szuwei-yeh/flashattn-accelerator/docs/v2/qwen/accuracy.csv

job | q_head | comparison | relative_l2 | rmse | max_abs
N16 | 0 | quantized_vs_original | 0.04211902249304501 | 0.0132997888426463 | 0.10851025581359863
N16 | 0 | fixed_vs_quantized | 0.008673786723758865 | 0.002759703978349715 | 0.015506148338317871
N16 | 0 | fixed_vs_original | 0.04117019603529227 | 0.013000180950784344 | 0.10507124662399292
N16 | 1 | quantized_vs_original | 0.020487900915049737 | 0.007270466146896582 | 0.03564310073852539
N16 | 1 | fixed_vs_quantized | 0.011445307668462 | 0.00406729459808457 | 0.02339792251586914
N16 | 1 | fixed_vs_original | 0.021737346887981148 | 0.007713852450170885 | 0.034595489501953125
N16 | 7 | quantized_vs_original | 0.24245916997373884 | 0.008346604892436544 | 0.017194723537613754
N16 | 7 | fixed_vs_quantized | 0.00028402957183590137 | 9.64776548555682e-06 | 0.00014071166515350342
N16 | 7 | fixed_vs_original | 0.24247522840710353 | 0.008347157700558841 | 0.017191611230373383
N16 | 8 | quantized_vs_original | 0.24601974835643559 | 0.008382410710682832 | 0.0239299014210701
N16 | 8 | fixed_vs_quantized | 0.12484606847263606 | 0.004086205005113992 | 0.02837306261062622
N16 | 8 | fixed_vs_original | 0.2895914804471752 | 0.009866991343743478 | 0.04273734334856272
N16 | all | quantized_vs_original | 0.04026771180620088 | 0.009613463005144974 | 0.10851025581359863
N16 | all | fixed_vs_quantized | 0.013335484229179613 | 0.003195935536698318 | 0.02837306261062622
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
all_18 | all | fixed_vs_quantized | 0.013677524601397597 | 0.00331555930922249 | 0.02837306261062622
all_18 | all | fixed_vs_original | 0.04061058591108217 | 0.00980630886969948 | 0.10507124662399292
