szuwei-yeh/flashattn-accelerator/docs/v2/evidence/results/power.csv

lanes | head_dim | query_heads | kv_heads | length | compact | AXI_modeled_latency | scope | status | host_latency_cycles | activity_cycles | duration_ns | switching_W | internal_W | leakage_W | total_W | dynamic_W | switching_nJ | internal_nJ | leakage_nJ | total_nJ | dynamic_nJ | sequential_file_percent | sequential_implied_percent | sequential_propagated_percent | all_net_default_percent | primary_input_file_percent
256 | 16 | 4 | 2 | 16 | 1 | 0 | warm_host_command_through_DONE_finalB | ACCEPTED_PRELAYOUT_STANDARD_CELL_ESTIMATE | 1228 | 1229 | 12290.0 | 0.00656408817 | 0.14768596 | 0.0285131261 | 0.182763174 | 0.15425004817000001 | 80.6726436093 | 1815.0604484 | 350.42631976900003 | 2246.15940846 | 1895.7330920093002 | 73.56929682182313 | 23.151735692968217 | 3.2789674852086494 | 1.9562697900746502 | 100.0
16 | 16 | 4 | 2 | 16 | 1 | 0 | warm_host_command_through_DONE_finalB | ACCEPTED_PRELAYOUT_STANDARD_CELL_ESTIMATE | 1292 | 1293 | 12930.0 | 0.00465624733 | 0.141513318 | 0.0130645866 | 0.159234151 | 0.14616956533 | 60.2052779769 | 1829.76720174 | 168.92510473800002 | 2058.89757243 | 1889.9724797169 | 77.6617598953222 | 19.060516846581617 | 3.277723258096173 | 1.493108623892482 | 100.0
