szuwei-yeh/flashattn-accelerator/docs/v2/evidence/results/ppa.csv

DEQUANT_LANES | standard_cell_area | library_leaf_cell_count | combinational_area | sequential_area | buffer_inverter_area | dequantizer_instance_area | shared_stage_including_lanes_area | critical_path_length_QoR_ns | critical_data_arrival_ns | setup_slack_ns | setup_TNS_ns | setup_violating_paths | mapped_latches | unresolved_references | max_cap_violations | zero_required_limit_cap_violations | max_transition_violations | elapsed_seconds | peak_process_RSS_KiB | status
256 | 5758250.967611 | 1549670 | 5070458.028295 | 687792.939316 | 798840.567031 | 3690838.9978 |  | 6.0 | 6.0001297 | 3.918528557 | 0.0 | 0 | 0 | 0 | 139337 | 139335 | 0 | 9382.316 | 7216464 | MEASURED_DC_PRELAYOUT_NOT_SIGNOFF
16 | 2395725.809614 | 660087 | 1717244.722517 | 678481.087097 | 337363.337018 | 228387.66400000002 | 336982.2743 | 9.47 | 9.470396042 | 0.459291458 | 0.0 | 0 | 0 | 0 | 132472 | 132471 | 0 | 6556.219 | 6245780 | MEASURED_DC_PRELAYOUT_NOT_SIGNOFF
