szuwei-yeh/flashattn-accelerator/docs/v2/evidence/verification/verification_matrix.csv

profile | log | seed | successful_commands | exact_words | held_edges | fault_cases | reset_checkpoints
d16_l256 | append_fault_latency0_seed0.log | 0 | 32 | 16896 | 888 | 8 | 0
d16_l256 | append_fault_latency0_seed17.log | 17 | 32 | 16896 | 888 | 8 | 0
d16_l256 | append_fault_latency0_seed20261010.log | 20261010 | 32 | 16896 | 888 | 8 | 0
d16_l256 | append_fault_latency20_seed0.log | 0 | 32 | 16896 | 888 | 8 | 0
d16_l256 | append_fault_latency20_seed17.log | 17 | 32 | 16896 | 888 | 8 | 0
d16_l256 | append_fault_latency20_seed20261010.log | 20261010 | 32 | 16896 | 888 | 8 | 0
d16_l256 | focus_latency0_seed0.log | 0 | 5 | 1152 | 111 | 0 | 0
d16_l256 | focus_latency0_seed17.log | 17 | 5 | 1152 | 111 | 0 | 0
d16_l256 | focus_latency0_seed20261010.log | 20261010 | 5 | 1152 | 111 | 0 | 0
d16_l256 | focus_latency20_seed0.log | 0 | 5 | 1152 | 111 | 0 | 0
d16_l256 | focus_latency20_seed17.log | 17 | 5 | 1152 | 111 | 0 | 0
d16_l256 | focus_latency20_seed20261010.log | 20261010 | 5 | 1152 | 111 | 0 | 0
d16_l256 | prefill_latency0_seed0.log | 0 | 1 | 1024 | 37 | 0 | 0
d16_l256 | prefill_latency0_seed17.log | 17 | 1 | 1024 | 37 | 0 | 0
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
