szuwei-yeh/flashattn-accelerator/docs/v2/evidence/results/decode_before_after.csv

kind | head_dim | latency | op | id | length | query | causal | ar_stalls | r_gaps | baseline_cycles | optimized_cycles | cycles_saved | baseline_total_counter | optimized_total_counter | baseline_core_busy | optimized_core_busy | dma_busy | baseline_update_cycles | optimized_update_cycles | baseline_normalization_cycles | optimized_normalization_cycles | other_phase_cycles | dma_bytes | ar_transactions | r_beats | cache_read_bytes | cache_write_bytes | output_stores | array_runs | array_compute_edges | exact_words | latency_reduction_percent | prediction_cycles_saved | baseline_phase0 | optimized_phase0 | baseline_phase1 | optimized_phase1 | baseline_phase2 | optimized_phase2 | baseline_phase3 | optimized_phase3 | baseline_phase4 | optimized_phase4 | baseline_phase5 | optimized_phase5 | baseline_phase6 | optimized_phase6 | baseline_phase7 | optimized_phase7 | baseline_phase8 | optimized_phase8 | baseline_phase9 | optimized_phase9 | baseline_phase10 | optimized_phase10 | baseline_phase11 | optimized_phase11 | baseline_phase12 | optimized_phase12
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
