szuwei-yeh/flashattn-accelerator/docs/v2/evidence/results/quickstart_jobs.csv

run | scope | dim | lanes | compact | job | operation | length | population | host_cycles | exact_words | historical_match | compute_cycles | read_bytes | write_bytes | ar | r | aw | w | b | okay | words | cache_reads | cache_writes | array_runs | array_compute | copy_cycles | issues | retires | dq_wait | update_cycles | norm_cycles | core_stores | result_stores
d16_l16_focus_warm | focus | 16 | 16 | 1 | 1 | 0 | 16 | 0 | 8143 | 1024 | PASS | 6258 | 2048 | 4096 | 16 | 256 | 33 | 512 | 33 | 33 | 1024 | 64 | 64 | 8 | 376 | 3072 | 64 | 64 | 68 | 1028 | 1028 | 2048 | 1024
d16_l16_focus_warm | focus | 16 | 16 | 1 | 2 | 1 | 16 | 0 | 26 | 0 | PASS | 23 | 64 | 0 | 4 | 8 | 0 | 0 | 0 | 0 | 0 | 0 | 4 | 0 | 0 | 0 | 0 | 0 | 0 | 0 | 0 | 0 | 0
d16_l16_focus_warm | focus | 16 | 16 | 1 | 3 | 2 | 17 | 0 | 2072 | 64 | PASS | 1947 | 64 | 256 | 4 | 8 | 3 | 32 | 3 | 3 | 64 | 68 | 0 | 16 | 752 | 192 | 128 | 128 | 136 | 136 | 68 | 192 | 64
d16_l16_focus_warm | focus | 16 | 16 | 1 | 4 | 1 | 17 | 0 | 26 | 0 | PASS | 23 | 64 | 0 | 4 | 8 | 0 | 0 | 0 | 0 | 0 | 0 | 4 | 0 | 0 | 0 | 0 | 0 | 0 | 0 | 0 | 0 | 0
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
