szuwei-yeh/flashattn-accelerator/docs/v2/evidence/results/soc_cycles.csv

engine | HEAD_DIM | compact | scope | AXI_latency | job_index | job_id | operation | KV_length | population | lanes256_host_cycles | lanes16_host_cycles | added_host_cycles | lanes256_compute_cycles | lanes16_compute_cycles | added_CORE_WAIT | query_DMA_wait_delta | lanes256_dq_wait | lanes16_dq_wait | lanes256_issues | lanes16_issues | lanes256_retires | lanes16_retires | score_tiles | score_words | update_cycles | normalization_cycles | core_stores | result_stores | read_bytes | write_bytes | ar | r | aw | w | b | okay | words | cache_reads | cache_writes | copy_cycles | array_runs | array_compute | baseline_log | shared_log | baseline_log_sha256 | shared_log_sha256 | classification
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
