szuwei-yeh/flashattn-accelerator/rtl/v2/compute/flash_attn_core_decode.sv

// d16/d64 shared QK/PV attention core; KV tiles load in the foreground (prefetch disabled).
// K/V are external persistent banked SRAMs. N16 prefill activates16 rows; decode activates row0.
`timescale 1ns/1ps
module flash_attn_core_decode_m3b #(
    parameter int TILE_SIZE=16, HEAD_DIM=16, SEQ_LEN=64, SRAM_DEPTH=4096,
    parameter int DEQUANT_LANES=256,
    parameter bit COMPACT_DECODE_OUTPUT=1'b0
)(
    input logic clk, rst_n, start, rearm,
    output logic done,
    input logic signed [15:0] scale_q, scale_k, scale_v,
    input logic causal, prefill,
    input logic [6:0] query_position, valid_kv_length,
    input logic dma_q_we,
    input logic [11:0] dma_q_addr,
    input logic [127:0] dma_q_data,
    output logic kv_r_en,
    output logic [11:0] kv_r_addr,
    input logic [127:0] kv_k_rdata, kv_v_rdata,
    input logic kv_r_valid,
    input logic [11:0] out_raddr,
    output logic signed [31:0] out_rdata,
    output logic loader_idle, array_idle, output_pipe_empty, core_active
);
    logic [6:0] query_position_reg;
    logic [15:0] tile_row, tile_col;
    logic [15:0] kv_len_reg;
    logic        causal_reg;
    logic             loader_mode;
    logic [3:0]  qrow_sel;
    logic [15:0] kv_tiles_ready;
    assign kv_tiles_ready = (kv_len_reg + 16'd15) >> 4;
    logic [4:0] loader_valid_rows;
    logic [15:0] remaining_rows;
    logic [15:0] key_mask[16];
    logic prefill_reg;
    logic [4:0] query_rows_reg;
    assign remaining_rows = kv_len_reg - tile_col;
    assign loader_valid_rows = loader_mode == 0 ? query_rows_reg : (remaining_rows >= 16 ? 5'd16 : remaining_rows[4:0]);
    for(genvar mr=0;mr<16;mr++) begin : gen_row_mask
        for(genvar mc=0;mc<16;mc++) begin : gen_key_mask
            assign key_mask[mr][mc] = (tile_col + 16'(mc) < kv_len_reg) &&
                (!causal_reg || tile_col + 16'(mc) <= (prefill_reg ? tile_row+16'(mr) : {9'd0,query_position_reg}));
        end
    end
    logic output_write_pending;
    localparam int SIZE       = TILE_SIZE;
    localparam int FLAT       = SIZE * SIZE;
    localparam int KV_FLAT    = SIZE * HEAD_DIM;
    localparam int NUM_CHUNKS = HEAD_DIM / TILE_SIZE;
    localparam int SRAM_ADDR_W = $clog2(SRAM_DEPTH);
    localparam int LOG2_T     = $clog2(TILE_SIZE);
    localparam int CHUNK_W    = (NUM_CHUNKS > 1) ? $clog2(NUM_CHUNKS) : 1;
    localparam int SCALE_SHIFT = $clog2(HEAD_DIM) / 2;
    localparam int NUM_BANKS  = 16;
    localparam int VEC_W      = NUM_BANKS * 8;
    localparam int IDX_W      = $clog2(KV_FLAT);
    localparam int TILE_BYTES = TILE_SIZE * HEAD_DIM;  // stride to next KV tile

    // This optimized implementation intentionally supports only the validated
    // fixed geometry.  Fail at elaboration/simulation instead of silently
    // building an address-truncated or numerically unsupported configuration.
    initial begin : p_parameter_guard
        if (!(HEAD_DIM == 16 || HEAD_DIM == 64) || SEQ_LEN != 64 || !(DEQUANT_LANES == 256 || DEQUANT_LANES == 16))
            $fatal(1, "M3B core supports d16/d64/capacity64/256 or 16 lanes");
        if (TILE_SIZE != 16)
            $fatal(1, "flash_attn_core_decode_m2c3: TILE_SIZE must be 16");
        if ((HEAD_DIM % TILE_SIZE) != 0)
            $fatal(1, "flash_attn_core_decode_m2c3: HEAD_DIM must be a TILE_SIZE multiple");
        if (!((HEAD_DIM == 16) || (HEAD_DIM == 64)))
            $fatal(1, "flash_attn_core_decode_m2c3: supported HEAD_DIM values are 16 and 64");
        if ((SEQ_LEN == 0) || ((SEQ_LEN % TILE_SIZE) != 0))
            $fatal(1, "flash_attn_core_decode_m2c3: SEQ_LEN must be a non-zero TILE_SIZE multiple");
        if ((SEQ_LEN * HEAD_DIM) > SRAM_DEPTH)
            $fatal(1, "flash_attn_core_decode_m2c3: SEQ_LEN*HEAD_DIM exceeds SRAM_DEPTH");
        if (SRAM_DEPTH != 4096)
            $fatal(1, "flash_attn_core_decode_m2c3: supported SRAM_DEPTH is 4096 (fixed 12-bit internal interfaces)");
        if (!(DEQUANT_LANES == 256 || DEQUANT_LANES == 16))
            $fatal(1, "flash_attn_core_decode_m2c3: DEQUANT_LANES must be 256 or 16");
    end

    // =========================================================
    // 1. Foreground tile/phase controller and address generation
    // =========================================================
    logic        cnt_en, cnt_clr, cnt_done, legacy_cnt_done;
    logic        ld_start, ld_mode, fsm_ld_done;
    logic        pf_start, kv_swap_banks;
    logic [15:0] pf_tile_col;
    logic        start_accepted;
    logic        transaction_consumed;
    logic        start_allowed;
    logic        mode_reg;
    logic signed [15:0] scale_v_reg;
    logic        array_start, array_done, array_busy;
    logic        array_no_clear;
    logic        softmax_tile_start, softmax_tile_valid, softmax_tile_last;
    logic        softmax_out_valid;
    logic        fused_update_en, norm_en;
    logic        short_cnt_mode;
    logic [CHUNK_W-1:0] k_chunk;
    logic        pv_done;
    logic [11:0] sram_addr_w12;
    /* verilator lint_off UNUSEDSIGNAL */
    logic [SRAM_ADDR_W-1:0] sram_addr_wide;
    /* verilator lint_on UNUSEDSIGNAL */
    logic [7:0]  sram_addr;

    logic        pf_valid;   // shadow buffer holds a complete next KV tile

    // Declared here (ahead of the tile_controller instance that reads bit 0)
    // so DC does not flag a non-standard forward reference. Softmax array
    // below drives bits [SIZE-1:0]; see section 6.
    logic [SIZE-1:0]     sfx_exp_valid;

    /* verilator lint_off UNUSEDSIGNAL */
    logic [3:0] _dbg_state;
    /* verilator lint_on UNUSEDSIGNAL */

    tile_controller_decode_m2c3 #(
        .TILE_SIZE(TILE_SIZE), .HEAD_DIM(HEAD_DIM), .SEQ_LEN(SEQ_LEN)
    ) u_fsm (
        .clk(clk), .rst_n(rst_n), .start(start_allowed), .done(done),
        .start_accepted(start_accepted),
        .mode(mode_reg), .kv_len(kv_len_reg),
        .tile_row(tile_row), .tile_col(tile_col),
        .cnt_en(cnt_en), .cnt_clr(cnt_clr), .cnt_done(cnt_done),
        .ld_start(ld_start), .ld_mode(ld_mode), .ld_done(fsm_ld_done),
        .pf_start(pf_start), .pf_tile_col(pf_tile_col),
        .pf_rdy(pf_valid), .kv_swap_banks(kv_swap_banks),
        .array_start(array_start), .array_no_clear(array_no_clear),
        .array_done(array_done),
        .softmax_tile_start(softmax_tile_start),
        .softmax_tile_valid(softmax_tile_valid),
        .softmax_tile_last(softmax_tile_last),
        .exp_out_valid(sfx_exp_valid[0]),
        .softmax_out_valid(softmax_out_valid),
        .fused_update_en(fused_update_en), .norm_en(norm_en),
        .short_cnt_mode(short_cnt_mode),
        .k_chunk(k_chunk),
        .pv_done(pv_done),
        .causal(1'b0),
        .kv_tiles_ready(kv_tiles_ready),
        .dbg_state(_dbg_state)
    );

    // One operation per explicit rearm. No internal reset is used between jobs.
    // Old output read ownership must be released before the next computation.
    assign start_allowed = start && !transaction_consumed;
    always_ff @(posedge clk or negedge rst_n) begin
        if (!rst_n)
            transaction_consumed <= 1'b0;
        else if (rearm)
            transaction_consumed <= 1'b0;
        else if (start_accepted)
            transaction_consumed <= 1'b1;
    end

    // Accepted-start is the single locking boundary for core-only and DMA-fed
    // use.  Q/K are represented by combined_scale_reg below; the remaining
    // transaction-level controls are captured explicitly here.
    always_ff @(posedge clk or negedge rst_n) begin
        if (!rst_n) begin
            mode_reg    <= 1'b0;
            prefill_reg<=0;query_rows_reg<=1;
            kv_len_reg  <= '0;
            causal_reg  <= 1'b0;
            query_position_reg <= 7'd15;
            scale_v_reg <= '0;
        end else if (start_accepted) begin
            mode_reg    <= 1'b1;
            prefill_reg<=prefill;query_rows_reg<=prefill ? 5'd16 : 5'd1;
            kv_len_reg  <= {9'd0,valid_kv_length};
            causal_reg  <= causal;
            query_position_reg <= query_position;
            scale_v_reg <= scale_v;
        end
    end

    /* verilator lint_off UNUSEDSIGNAL */
    logic [31:0] q_global_offset, k_global_offset;
    logic [31:0] dummy_v_off;
    /* verilator lint_on UNUSEDSIGNAL */

    addr_gen #(.MAX_SRAM_DEPTH(SRAM_DEPTH)) u_addr_gen (
        .clk(clk), .rst_n(rst_n),
        .seq_len(16'(SEQ_LEN)), .head_dim(16'(HEAD_DIM)), .tile_size(16'(TILE_SIZE)),
        .tile_row(tile_row), .tile_col(tile_col),
        .cnt_en(cnt_en), .cnt_clr(cnt_clr),
        .short_cnt_mode(short_cnt_mode),
        .sram_addr(sram_addr_w12), .cnt_done(legacy_cnt_done),
        .q_global_offset(q_global_offset),
        .k_global_offset(k_global_offset),
        .v_global_offset(dummy_v_off)
    );
    // With COMPACT_DECODE_OUTPUT=1, one accepted decode query visits its owned row; otherwise traverse all rows.
    // Delayed SRAM writes retire in the following controller state.
    logic compact_output_selected;
    assign compact_output_selected = COMPACT_DECODE_OUTPUT && ((HEAD_DIM == 16) || (HEAD_DIM == 64))
                                   && !prefill_reg && (query_rows_reg == 5'd1)
                                   && short_cnt_mode;
    assign cnt_done = compact_output_selected
                    ? (sram_addr_w12 == 12'd15 && cnt_en) : legacy_cnt_done;
    assign sram_addr_wide = SRAM_ADDR_W'(sram_addr_w12);
    assign sram_addr      = sram_addr_w12[7:0];

    // Output address (output_buffer), identical to flash_attn_core_banked
    logic [SRAM_ADDR_W-1:0] out_global_addr;
    assign out_global_addr  = q_global_offset[SRAM_ADDR_W-1:0]
                            + SRAM_ADDR_W'(sram_addr[2*LOG2_T-1:LOG2_T]) * SRAM_ADDR_W'(HEAD_DIM)
                            + SRAM_ADDR_W'(k_chunk) * SRAM_ADDR_W'(TILE_SIZE)
                            + SRAM_ADDR_W'(sram_addr[LOG2_T-1:0]);

    // =========================================================
    // 2. Banked scratchpads (Q, K, V) + shared tile loader
    // =========================================================
    localparam logic MODE_Q  = 1'b0;
    localparam logic MODE_KV = 1'b1;

    logic                 q_r_en, k_r_en, v_r_en;
    logic [11:0]          q_r_addr, k_r_addr, v_r_addr;
    logic [VEC_W-1:0]     q_r_vdata, k_r_vdata, v_r_vdata;

    // Foreground load base (Q offset for Q load, K offset for KV load).
    logic [11:0] ld_base_addr;
    assign ld_base_addr = (ld_mode == MODE_Q) ? q_global_offset[11:0]
                                              : k_global_offset[11:0];
    // Prefetch base: the NEXT KV tile = current K tile offset + one tile stride.
    logic [11:0] pf_base_addr;
    assign pf_base_addr = k_global_offset[11:0] + 12'(TILE_BYTES);

    // ── Shared loader arbitration ────────────────────────────────────────────
    // pf_start and ld_start never coincide (different FSM states).
    logic             loader_start;
    logic [11:0]      loader_base;
    logic             loader_done;
    assign loader_start = ld_start | pf_start;
    assign loader_mode  = pf_start ? MODE_KV : ld_mode;
    assign loader_base  = pf_start ? pf_base_addr : ld_base_addr;

    // pf_load_active: high for the duration of a prefetch load. Set on pf_start,
    // cleared when the loader completes.  Used to (a) de-mux loader_done into the
    // FSM's foreground ld_done vs pf_done, and (b) route stripe writes to shadow.
    logic pf_load_active;
    always_ff @(posedge clk or negedge rst_n) begin
        if (!rst_n)               pf_load_active <= 1'b0;
        else if (rearm || start_accepted) pf_load_active <= 1'b0;
        else if (pf_start)        pf_load_active <= 1'b1;
        else if (loader_done)     pf_load_active <= 1'b0;
    end

    // De-mux the single loader's done pulse.
    assign fsm_ld_done = loader_done & ~pf_load_active;   // foreground completion
    logic pf_done;
    assign pf_done     = loader_done &  pf_load_active;   // prefetch completion

    // pf_valid: shadow holds a complete next tile.  Set on prefetch completion,
    // cleared on swap / new prefetch / new run.
    always_ff @(posedge clk or negedge rst_n) begin
        if (!rst_n)              pf_valid <= 1'b0;
        else if (rearm)          pf_valid <= 1'b0;
        else if (start_accepted) pf_valid <= 1'b0;
        else if (pf_start)       pf_valid <= 1'b0;   // shadow being refilled
        else if (kv_swap_banks)  pf_valid <= 1'b0;   // shadow consumed
        else if (pf_done)        pf_valid <= 1'b1;   // shadow ready
    end

    logic             ld_wr_en;
    logic [IDX_W-1:0] ld_wr_index;
    logic [VEC_W-1:0] q_stripe, k_stripe, v_stripe;
    /* verilator lint_off UNUSEDSIGNAL */
    logic             ld_busy;
    /* verilator lint_on UNUSEDSIGNAL */

    banked_tile_loader_decode_m2c3 #(
        .TILE_SIZE(TILE_SIZE), .HEAD_DIM(HEAD_DIM),
        .NUM_BANKS(NUM_BANKS), .SP_ADDR_W(12)
    ) u_loader (
        .clk(clk), .rst_n(rst_n),
        .start(loader_start), .mode(loader_mode), .base_addr(loader_base),.valid_rows(loader_valid_rows),
        .q_r_en(q_r_en), .q_r_addr(q_r_addr), .q_r_vdata(q_r_vdata),
        .k_r_en(k_r_en), .k_r_addr(k_r_addr), .k_r_vdata(k_r_vdata),
        .v_r_en(v_r_en), .v_r_addr(v_r_addr), .v_r_vdata(v_r_vdata),
        .wr_en(ld_wr_en), .wr_index(ld_wr_index),
        .q_stripe(q_stripe), .k_stripe(k_stripe), .v_stripe(v_stripe),
        .busy(ld_busy), .done(loader_done)
    );

    // Sole Q store. K/V stores live in kv_cache_banked_decode_m2c3 and supply this loader.
    /* verilator lint_off PINCONNECTEMPTY */
    banked_scratchpad #(.NUM_BANKS(16), .DATA_WIDTH(8), .DEPTH(4096)) u_q_sp (
        .clk(clk), .w_en(dma_q_we), .w_vec(1'b1), .w_addr(dma_q_addr),
        .w_sdata(8'd0), .w_vdata(dma_q_data),
        .r_en(q_r_en), .r_vec(1'b1), .r_addr(q_r_addr),
        .r_sdata(), .r_vdata(q_r_vdata)
    );
    /* verilator lint_on PINCONNECTEMPTY */
    assign kv_r_en = k_r_en;
    assign kv_r_addr = k_r_addr;
    assign k_r_vdata = kv_k_rdata;
    assign v_r_vdata = kv_v_rdata;
    assign loader_idle = !ld_busy && !pf_load_active;
    assign array_idle = !array_busy;
    assign output_pipe_empty = !(fused_update_en && {1'b0,qrow_sel} < query_rows_reg) &&
                               !(norm_en && {1'b0,qrow_sel} < query_rows_reg) && !output_write_pending;
    always_ff @(posedge clk or negedge rst_n) begin
        if (!rst_n) begin
            output_write_pending <= 1'b0;
            core_active <= 1'b0;
        end else begin
            output_write_pending <= (fused_update_en || norm_en) && {1'b0,qrow_sel} < query_rows_reg;
            if (start_accepted) core_active <= 1'b1;
            else if (done || rearm) core_active <= 1'b0;
        end
    end

    // =========================================================
    // 3. Tile Registers — active + shadow (double buffer)
    //    Active  : consumed by the slicing mux (compute).
    //    Shadow  : filled by a prefetch load; copied to active on kv_swap_banks.
    // =========================================================
    logic signed [7:0] Q_reg     [KV_FLAT-1:0];
    logic signed [7:0] K_reg     [KV_FLAT-1:0];
    logic signed [7:0] V_reg     [KV_FLAT-1:0];
    logic signed [7:0] K_shadow  [KV_FLAT-1:0];
    logic signed [7:0] V_shadow  [KV_FLAT-1:0];

    // Loader stripe writes:
    //   pf_load_active=1 → prefetch load → shadow K/V (loader is always KV mode).
    //   pf_load_active=0 → foreground load → Q_reg (ld_mode=Q) or K/V_reg (KV).
    // ld_mode is held stable by the FSM for the whole foreground load, so it is a
    // valid routing signal here.
    always_ff @(posedge clk) begin
        if (ld_wr_en) begin
            if (pf_load_active) begin
                for (int i = 0; i < NUM_BANKS; i++) begin
                    K_shadow[int'(ld_wr_index) + i] <= signed'(k_stripe[i*8 +: 8]);
                    V_shadow[int'(ld_wr_index) + i] <= signed'(v_stripe[i*8 +: 8]);
                end
            end else if (ld_mode == MODE_Q) begin
                for (int i = 0; i < NUM_BANKS; i++)
                    Q_reg[int'(ld_wr_index) + i] <= signed'(q_stripe[i*8 +: 8]);
            end else begin
                for (int i = 0; i < NUM_BANKS; i++) begin
                    K_reg[int'(ld_wr_index) + i] <= signed'(k_stripe[i*8 +: 8]);
                    V_reg[int'(ld_wr_index) + i] <= signed'(v_stripe[i*8 +: 8]);
                end
            end
        end
        // Copy-style swap: shadow → active in one cycle (baseline style).
        if (kv_swap_banks && pf_valid) begin
            for (int pi = 0; pi < KV_FLAT; pi++) begin
                K_reg[pi] <= K_shadow[pi];
                V_reg[pi] <= V_shadow[pi];
            end
        end
    end

    // =========================================================
    // 4. Systolic Array + Data Slicing Mux  (verbatim from flash_attn_core_banked)
    // =========================================================
    logic is_pv_phase;
    always_ff @(posedge clk or negedge rst_n) begin
        if (!rst_n)
            is_pv_phase <= 1'b0;
        else if (rearm || start_accepted)
            is_pv_phase <= 1'b0;
        else if (sfx_exp_valid[0])
            is_pv_phase <= 1'b1;
        else if (pv_done)
            is_pv_phase <= 1'b0;
    end

    logic signed [7:0]  p_matrix_int8 [FLAT-1:0];
    logic signed [7:0]  array_a_in    [FLAT-1:0];
    logic signed [7:0]  array_b_in    [FLAT-1:0];
    logic signed [31:0] array_acc     [FLAT-1:0];

    for (genvar gi = 0; gi < FLAT; gi++) begin : gen_mux
        assign array_a_in[gi] = is_pv_phase
            ? p_matrix_int8[gi]
            : Q_reg[(gi/SIZE)*HEAD_DIM + int'(k_chunk)*TILE_SIZE + (gi%SIZE)];
        assign array_b_in[gi] = is_pv_phase
            ? V_reg[(gi/SIZE)*HEAD_DIM + int'(k_chunk)*TILE_SIZE + (gi%SIZE)]
            : K_reg[(gi%SIZE)*HEAD_DIM + int'(k_chunk)*TILE_SIZE + (gi/SIZE)];
    end

    array_controller #(.SIZE(SIZE)) u_array_ctrl (
        .clk(clk), .rst_n(rst_n),
        .a_flat(array_a_in), .b_flat(array_b_in),
        .start(array_start), .no_clear(array_no_clear),
        .a_unsigned(is_pv_phase),
        .busy(array_busy), .done(array_done),
        .acc(array_acc)
    );

    // =========================================================
    // 5. Dequantizers (last QK chunk only)  (verbatim)
    // =========================================================
    logic signed [15:0] dequant_out   [FLAT-1:0];
    logic [FLAT-1:0]    dequant_valid;
    logic               dequant_tile_ready;

    logic is_last_qk_chunk;
    assign is_last_qk_chunk = (k_chunk == CHUNK_W'(NUM_CHUNKS - 1));

    // Exact shared Q8.8 × Q8.8 product, captured only when the controller
    // accepts a new transaction.  Keep all 32 signed result bits so every lane
    // can perform one full-precision signed 32×32 multiplication.
    logic signed [31:0] combined_scale_product;
    logic signed [31:0] combined_scale_reg;
    assign combined_scale_product = signed'(scale_q) * signed'(scale_k);

    always_ff @(posedge clk or negedge rst_n) begin
        if (!rst_n)
            combined_scale_reg <= '0;
        else if (start_accepted)
            combined_scale_reg <= combined_scale_product;
    end

    if (DEQUANT_LANES == 256) begin : gen_parallel_dequant
        // Preserve the original one-cycle parallel datapath and start timing.
        assign dequant_tile_ready = 1'b1;
        for (genvar gi = 0; gi < FLAT; gi++) begin : gen_dequant
            dequantizer #(.OUT_WIDTH(16), .FRAC_BITS(8)) u_deq (
                .clk(clk), .rst_n(rst_n),
                .valid_in(array_done && !is_pv_phase && is_last_qk_chunk),
                .data_in(array_acc[gi]), .combined_scale(combined_scale_reg),
                .valid_out(dequant_valid[gi]), .data_out(dequant_out[gi])
            );
        end
    end else begin : gen_shared_dequant
        logic batch_busy;
        logic batch_done;
        dequantizer_tile #(.LANES(DEQUANT_LANES)) u_dequant_tile (
            .clk(clk), .rst_n(rst_n),
            .valid_in(array_done && !is_pv_phase && is_last_qk_chunk),
            .data_in(array_acc), .combined_scale(combined_scale_reg),
            .data_out(dequant_out), .busy(batch_busy), .done(batch_done),
            .tile_ready(dequant_tile_ready)
        );
        assign dequant_valid = {FLAT{batch_done}};
        // synthesis translate_off
        always @(posedge clk or negedge rst_n) begin
            if (rst_n && batch_busy && array_start)
                $fatal(1, "array reuse before shared dequantization completes");
        end
        // synthesis translate_on
    end

    // =========================================================
    // 6. Online Softmax (SIZE rows parallel)  (verbatim)
    // =========================================================
    logic [15:0]         sfx_rescale_q88  [SIZE-1:0];
    logic [31:0]         sfx_running_sum  [SIZE-1:0];
    logic [SIZE*16-1:0]  sfx_exp_flat     [SIZE-1:0];
    logic [SIZE-1:0]     softmax_valid_arr;

    /* verilator lint_off UNUSEDSIGNAL */
    logic [SIZE*16-1:0]  softmax_flat_out [SIZE-1:0];
    logic [2:0]          sfx_dbg_state    [SIZE-1:0];
    logic [SIZE-1:0]     sfx_rescale_valid;
    /* verilator lint_on UNUSEDSIGNAL */

    logic sfx_triggered;
    logic tile_valid_pulse;
    always_ff @(posedge clk or negedge rst_n) begin
        if (!rst_n)                    sfx_triggered <= 1'b0;
        else if (rearm || start_accepted) sfx_triggered <= 1'b0;
        else if (sfx_exp_valid[0])     sfx_triggered <= 1'b0;
        else if (tile_valid_pulse)     sfx_triggered <= 1'b1;
    end
    assign tile_valid_pulse = softmax_tile_valid && dequant_tile_ready && !sfx_triggered;

    // Sixteen V1 arithmetic rows; only accepted query rows can trigger/update.
    for (genvar r = 0; r < SIZE; r++) begin : gen_softmax
        if (1) begin : active_row
            logic [SIZE*16-1:0] row_scores;
            for (genvar c = 0; c < SIZE; c++) begin : gen_pack
                assign row_scores[c*16 +: 16] = dequant_out[r*SIZE+c] >>> SCALE_SHIFT;
                assign p_matrix_int8[r*SIZE+c] = (5'(r)<query_rows_reg) ? signed'(sfx_exp_flat[r][c*16 +: 8]) : 8'sd0;
            end
            online_softmax_masked_m2c3 #(.DIM(16), .EMIT_NORMALIZED_OUTPUT(0)) u_softmax (
                .clk(clk), .rst_n(rst_n), .tile_start(softmax_tile_start),
                .tile_valid(tile_valid_pulse && 5'(r)<query_rows_reg), .tile_last(softmax_tile_last),
                .scores_flat(row_scores),.key_mask(key_mask[r]), .exp_out_valid(sfx_exp_valid[r]),
                .exp_flat(sfx_exp_flat[r]), .rescale_valid(sfx_rescale_valid[r]),
                .rescale_q88(sfx_rescale_q88[r]), .running_sum_out(sfx_running_sum[r]),
                .out_valid(softmax_valid_arr[r]), .softmax_flat(softmax_flat_out[r]),
                .dbg_state(sfx_dbg_state[r])
            );
        end
    end

    assign softmax_out_valid = softmax_valid_arr[0];

    // =========================================================
    // 7. Output Buffer — fused rescale + PV accumulation
    // =========================================================
    /* verilator lint_off UNUSEDSIGNAL */
    logic signed [47:0] pv_scaled_wide;
    /* verilator lint_on UNUSEDSIGNAL */
    logic signed [31:0] accum_data_in;
    assign pv_scaled_wide = 48'(signed'(array_acc[sram_addr])) * 48'(signed'(scale_v_reg));
    assign accum_data_in  = $signed(pv_scaled_wide[39:8]);

    logic done_latch;
    always_ff @(posedge clk or negedge rst_n) begin
        if (!rst_n)     done_latch <= 1'b0;
        else if (rearm) done_latch <= 1'b0;
        else if (done)  done_latch <= 1'b1;
        else if (start_accepted) done_latch <= 1'b0;
    end

    logic [15:0] rescale_q88_sel;
    logic [31:0] norm_divisor_sel;
    assign qrow_sel         = sram_addr[2*LOG2_T-1:LOG2_T];
    assign rescale_q88_sel  = sfx_rescale_q88[qrow_sel];
    assign norm_divisor_sel = sfx_running_sum [qrow_sel];

    output_buffer #(.DATA_WIDTH(32), .DEPTH(SRAM_DEPTH)) u_out_buf (
        .clk(clk), .rst_n(rst_n),
        .first_tile(tile_col == 16'd0),
        // Assert both legacy update enables to select output_buffer's fused mode.
        .accum_en(fused_update_en && {1'b0,qrow_sel} < query_rows_reg),     .addr(out_global_addr[11:0]),         .data_in(accum_data_in),
        .rescale_en(fused_update_en && {1'b0,qrow_sel} < query_rows_reg),   .rescale_addr(out_global_addr[11:0]), .rescale_q88(rescale_q88_sel),
        .norm_en(norm_en && {1'b0,qrow_sel} < query_rows_reg), .norm_addr(out_global_addr[11:0]),    .norm_divisor(norm_divisor_sel),
        .re_ext(done_latch), .raddr_ext(out_raddr),
        .rdata_ext(out_rdata)
    );

    // synthesis translate_off
    // Monitor the real shared loader and register-bank handoff, complementing
    // the abstract controller formal harness. Counts are consumer-edge writes.
    integer check_stripes;
    logic check_loading, check_shadow_complete, check_active_valid;
    logic [15:0] check_shadow_tile, check_active_tile;
    always @(posedge clk or negedge rst_n) begin
        if (!rst_n || rearm || start_accepted) begin
            check_stripes <= 0;
            check_loading <= 1'b0;
            check_shadow_complete <= 1'b0;
            check_active_valid <= 1'b0;
            check_shadow_tile <= '0;
            check_active_tile <= '0;
        end else begin
            if (pf_start || kv_swap_banks) $fatal(1, "M2C.3 prefetch must remain disabled");
            if (k_r_en != v_r_en || k_r_addr != v_r_addr)
                $fatal(1, "unpaired cache read");
            if (ld_wr_en && ld_mode == MODE_KV && (loader_valid_rows == 16 || ld_wr_index < IDX_W'(loader_valid_rows*HEAD_DIM)) && !kv_r_valid)
                $fatal(1, "cache data not valid at loader consume edge");
            if (u_out_buf.we && {1'b0,u_out_buf.waddr} >= 13'(int'(query_rows_reg)*HEAD_DIM))
                $fatal(1, "inactive query row output write");
            if (ld_start && pf_start) $fatal(1, "foreground/prefetch loader conflict");
            if (loader_start) begin
                if (check_loading) $fatal(1, "loader request while occupied");
                check_loading <= 1'b1;
                check_stripes <= 0;
            end
            if (pf_start) begin
                check_shadow_tile <= pf_tile_col;
                check_shadow_complete <= 1'b0;
            end
            if (ld_wr_en) begin
                if (!check_loading || int'(ld_wr_index) != check_stripes * NUM_BANKS)
                    $fatal(1, "loader stripe gap, duplicate, or unexpected write");
                if (!pf_load_active && ld_mode == MODE_KV && array_busy)
                    $fatal(1, "active K/V overwritten during compute");
                check_stripes <= check_stripes + 1;
            end
            if (loader_done) begin
                if (!check_loading || check_stripes != KV_FLAT / NUM_BANKS)
                    $fatal(1, "loader completion before a complete tile");
                check_loading <= 1'b0;
                if (pf_load_active) check_shadow_complete <= 1'b1;
                else if (ld_mode == MODE_KV) begin
                    check_active_valid <= 1'b1;
                    check_active_tile <= tile_col;
                end
            end
            if (kv_swap_banks) begin
                if (!pf_valid || !check_shadow_complete || check_shadow_tile != tile_col || array_busy)
                    $fatal(1, "invalid or busy shadow promotion");
                check_active_valid <= 1'b1;
                check_active_tile <= check_shadow_tile;
                check_shadow_complete <= 1'b0;
            end
            if (array_start && (!check_active_valid || check_active_tile != tile_col ||
                                (tile_col >> LOG2_T) >= kv_tiles_ready))
                $fatal(1, "compute consumes incomplete/nonresident/wrong tile");
        end
    end
    // synthesis translate_on

    // ── Suppress unused warnings ──────────────────────────────
    /* verilator lint_off UNUSEDSIGNAL */
    logic _unused;
    assign _unused = &{
        array_busy, ld_busy, dummy_v_off, pf_tile_col,
        dequant_valid, softmax_valid_arr[SIZE-1:1],
        sfx_exp_valid[SIZE-1:1],
        1'b0
    };
    /* verilator lint_on UNUSEDSIGNAL */

endmodule
