szuwei-yeh/flashattn-accelerator/syn/blackboxes/sram_1r1w_bb.sv

`timescale 1ns/1ps

// Synthesis-only blackbox for SRAM macro modeling.
// Replaces rtl/memory/sram_1r1w.sv in macro-based DC runs.
module sram_1r1w #(
    parameter int DATA_WIDTH = 8,
    parameter int DEPTH      = 256,
    localparam int ADDR_WIDTH = $clog2(DEPTH)
)(
    input  logic                  clk,
    input  logic                  we,
    input  logic [ADDR_WIDTH-1:0] waddr,
    input  logic [DATA_WIDTH-1:0] wdata,
    input  logic                  re,
    input  logic [ADDR_WIDTH-1:0] raddr,
    output logic [DATA_WIDTH-1:0] rdata
);
endmodule
