szuwei-yeh/flashattn-accelerator/sim/verilator/tb_dma_banked_prefetch.cpp

// ============================================================
//  tb_dma_banked_prefetch.cpp — end-to-end test for
//  flash_attn_top_dma_banked_prefetch (vector DMA + banked core WITH KV
//  double-buffering).
//
//  Same flow as tb_dma_banked.cpp: vector DMA fills the banked scratchpads from
//  the DRAM model, result compared to the golden expected.hex.  Sweeps DRAM
//  rd_latency {0,20,100} with the same runtime config and prints the RTL
//  performance counters, so latency-independence and the prefetch reduction in
//  perf_core_busy_cycles can be read off directly.
// ============================================================
#include <cstdio>
#include <cstdlib>
#include <cstdint>
#include <cstring>
#include <cmath>
#include <vector>
#include <string>

#include "Vtb_dma_banked_prefetch_harness.h"
#include "verilated.h"
#include "tb_fixture_checks.h"

static void tick(Vtb_dma_banked_prefetch_harness* d) { d->clk = 0; d->eval(); d->clk = 1; d->eval(); }


struct Res {
    bool     pass;
    int      exact_fail;
    int      numerical_fail;
    double   max_rel, max_abs;
    int      tb_cycles;
    uint32_t perf_total, perf_dma_busy, perf_core_busy, perf_first_wait, perf_dma_bytes;
    uint16_t perf_kv_tiles;
    bool     cfg_err;
    bool     timeout;
};

// One end-to-end run at a given rd_latency. Fresh DUT each time so scratchpad /
// output-buffer state cannot leak between runs.
static Res run_once(int N, int D, int latency,
                    const std::vector<int8_t>& q, const std::vector<int8_t>& k,
                    const std::vector<int8_t>& v, const std::vector<int32_t>& exp,
                    uint16_t sq, uint16_t sk, uint16_t sv, bool causal) {
    const int MAT = N * D;
    auto* dut = new Vtb_dma_banked_prefetch_harness;
    dut->inject_rresp = 0; dut->inject_bad_rlast = 0;
    Res r{}; r.timeout = false;

    // Reset
    dut->rst_n = 0; dut->start = 0; dut->causal = causal; dut->init_we = 0; dut->out_raddr = 0;
    dut->rd_latency = (uint16_t)latency;
    dut->scale_q = sq; dut->scale_k = sk; dut->scale_v = sv;
    tick(dut); tick(dut);
    dut->rst_n = 1; tick(dut);

    // Backdoor-load DRAM: Q@0, K@MAT, V@2*MAT
    auto dram = [&](int base, const std::vector<int8_t>& s) {
        for (int i = 0; i < (int)s.size(); i++) {
            dut->init_we = 1; dut->init_addr = base + i; dut->init_data = (uint8_t)s[i]; tick(dut);
        }
        dut->init_we = 0; tick(dut);
    };
    dram(0, q); dram(MAT, k); dram(2 * MAT, v);

    // Same runtime config for every latency
    dut->cfg_seq_len = (uint16_t)N;
    dut->cfg_q_base  = 0;
    dut->cfg_k_base  = (uint32_t)MAT;
    dut->cfg_v_base  = (uint32_t)(2 * MAT);
    tick(dut);
    r.cfg_err = dut->cfg_error;
    if (r.cfg_err) { delete dut; r.pass = false; return r; }

    // Run
    int max_cycle = N * N * 20 * (D / 16) + 50000;
    int cyc = 0; bool done = false;
    dut->start = 1; tick(dut); dut->start = 0;
    while (cyc < max_cycle) {
        tick(dut); cyc++;
        if (dut->done) { done = true; break; }
    }
    if (!done) { r.timeout = true; r.pass = false; delete dut; return r; }
    r.tb_cycles = cyc;

    // Read output
    std::vector<int32_t> hw(MAT);
    for (int i = 0; i < MAT; i++) {
        dut->out_raddr = i; tick(dut); tick(dut);
        hw[i] = (int32_t)dut->out_rdata;
    }

    r.exact_fail = 0; r.numerical_fail = 0; r.max_rel = 0.0; r.max_abs = 0.0;
    for (int i = 0; i < MAT; i++) {
        double h = hw[i] / 256.0, e = exp[i] / 256.0;
        double ae = fabs(h - e), ref = fabs(e);
        double re = (ref > 1e-3) ? ae / ref : 0.0;
        if (ae > r.max_abs) r.max_abs = ae;
        if (re > r.max_rel) r.max_rel = re;
        if ((ref > 1e-3 && re > 0.05) || (ref <= 1e-3 && ae > 0.05))
            r.numerical_fail++;
        if (hw[i] != exp[i]) r.exact_fail++;
    }
    r.pass = (r.exact_fail == 0);

    r.perf_total     = (uint32_t)dut->perf_total_cycles;
    r.perf_dma_busy  = (uint32_t)dut->perf_dma_busy_cycles;
    r.perf_core_busy = (uint32_t)dut->perf_core_busy_cycles;
    r.perf_first_wait= (uint32_t)dut->perf_first_tile_wait_cycles;
    r.perf_dma_bytes = (uint32_t)dut->perf_dma_bytes;
    r.perf_kv_tiles  = (uint16_t)dut->perf_kv_tiles_loaded;

    delete dut;
    return r;
}

int main(int argc, char** argv) {
    int N = TB_SEQ_LEN, D = TB_HEAD_DIM; std::string data = "../../data/N64";
    bool causal = false;
    // Non-prefetch banked top's core_busy for this shape — the reference the KV
    // double buffer must beat. Default 11930 = dma_banked_top_N64 (N=64,d=16);
    // pass --core_busy_ref for other shapes (e.g. 45590 for N=64,d=64).
    uint32_t core_busy_ref = 11930;
    for (int i = 1; i < argc; i++) {
        if (!strcmp(argv[i], "--N") && i + 1 < argc) N = atoi(argv[++i]);
        else if (!strcmp(argv[i], "--D") && i + 1 < argc) D = atoi(argv[++i]);
        else if (!strcmp(argv[i], "--data") && i + 1 < argc) data = argv[++i];
        else if (!strcmp(argv[i], "--core_busy_ref") && i + 1 < argc) core_busy_ref = (uint32_t)strtoul(argv[++i], nullptr, 10);
        else if (!strcmp(argv[i], "--causal")) causal = true;
    }
    if (!check_tb_geometry(N, D, TB_SEQ_LEN, TB_HEAD_DIM)) return 1;
    const int MAT = N * D;

    std::vector<int8_t> q, k, v; std::vector<int32_t> exp;
    if (!load_hex_vector((data + "/q_input.hex").c_str(), q, MAT)) return 1;
    if (!load_hex_vector((data + "/k_input.hex").c_str(), k, MAT)) return 1;
    if (!load_hex_vector((data + "/v_input.hex").c_str(), v, MAT)) return 1;
    if (!load_hex_vector((data + "/expected.hex").c_str(), exp, MAT)) return 1;
    uint16_t sq = 0x100, sk = 0x100, sv = 0x100;
    if (!load_required_scales(data + "/scales.txt", sq, sk, sv)) return 1;

    Verilated::commandArgs(argc, argv);

    printf("=== flash_attn_top_dma_banked_prefetch: N=%d D=%d — rd_latency sweep ===\n", N, D);
    printf("    config (all latencies): cfg_seq_len=%d  cfg_q,k,v_base=0,%d,%d\n\n",
           N, MAT, 2 * MAT);

    const int lats[] = {0, 20, 100};
    const uint32_t exp_bytes = (uint32_t)(3 * MAT);   // Q+K+V each streamed once
    const uint16_t exp_tiles = (uint16_t)(N / 16);    // KV tile pairs

    printf("  rd_lat  result  tb_cyc  perf_total  dma_busy  core_busy  first_wait  dma_bytes  kv_tiles\n");
    printf("  ------  ------  ------  ----------  --------  ---------  ----------  ---------  --------\n");

    // Non-prefetch banked top reference core_busy (constant across latency).  The
    // double buffer must beat that; and it degrades gracefully (core_busy grows
    // only slightly with latency — see note below).  Shape-dependent, so it comes
    // from --core_busy_ref (default 11930 = dma_banked_top_N64, N=64 d=16).
    const uint32_t CORE_BUSY_NOPREFETCH = core_busy_ref;

    bool all_pass = true;
    bool invariants_ok = true;
    int total_exact_mismatches = 0;
    uint32_t core_busy_rl0 = 0;
    for (int li = 0; li < 3; li++) {
        Res r = run_once(N, D, lats[li], q, k, v, exp, sq, sk, sv, causal);
        if (r.cfg_err) { printf("  %5d   CFG_ERROR\n", lats[li]); all_pass = false; continue; }
        if (r.timeout) { printf("  %5d   TIMEOUT\n", lats[li]); all_pass = false; continue; }

        printf("  %5d  %-6s  %6d  %10u  %8u  %9u  %10u  %9u  %8u\n",
               lats[li], r.pass ? "PASS" : "FAIL", r.tb_cycles,
               r.perf_total, r.perf_dma_busy, r.perf_core_busy,
               r.perf_first_wait, r.perf_dma_bytes, r.perf_kv_tiles);

        if (!r.pass) all_pass = false;
        total_exact_mismatches += r.exact_fail;
        if (!r.pass)
            printf("           exact=%d max_abs=%.6f max_rel=%.4f%% entries>5%%=%d\n",
                   r.exact_fail, r.max_abs, r.max_rel * 100.0, r.numerical_fail);
        // Work-done counters are latency-invariant (they count work, not time).
        if (r.perf_dma_bytes != exp_bytes || r.perf_kv_tiles != exp_tiles) invariants_ok = false;
        // Every run: RTL counter starts one cycle earlier than the C++ loop.
        if (r.perf_total != (uint32_t)(r.tb_cycles + 1)) invariants_ok = false;
        // The stored baseline is noncausal. Do not compare causal execution
        // against a workload that performs more tiles.
        if (!causal && r.perf_core_busy >= CORE_BUSY_NOPREFETCH) invariants_ok = false;
        if (li == 0) core_busy_rl0 = r.perf_core_busy;
    }

    printf("\n  Notes:\n");
    printf("  - perf_total_cycles = tb_cycles + 1 every row (t=0 placed one cycle apart).\n");
    printf("  - perf_dma_bytes = %u and perf_kv_tiles_loaded = %u are latency-invariant\n",
           exp_bytes, exp_tiles);
    printf("    (they count work done, not time): %s\n", invariants_ok ? "CONFIRMED" : "MISMATCH");
    if (causal) {
        printf("  - Causal run: no speedup comparison against the noncausal baseline.\n");
    } else {
    printf("  - KV double-buffer: core_busy=%u at rd_lat=0 — below the non-prefetch top's %u,\n",
           core_busy_rl0, CORE_BUSY_NOPREFETCH);
    printf("    i.e. the KV loads that used to serialize before compute are now hidden.\n");
    printf("  - Unlike the non-prefetch top, core_busy grows slightly with rd_latency: the\n");
    printf("    prefetch fires early (S_UPDATE_SOFTMAX); when a tile has not streamed in yet it\n");
    printf("    gates off and falls back to the residency-stalled reload (graceful degradation).\n");
    printf("    first_wait still absorbs the bulk of the latency and every run stays bit-exact.\n");
    }
    printf("  - exact mismatches across all latency points: %d\n",
           total_exact_mismatches);

    bool ok = all_pass && invariants_ok;
    printf("\n=== Coverage Summary ===\n");
    printf("Module           : flash_attn_top_dma_banked_prefetch\n");
    printf("Scenarios covered: vector_dma_banked_prefetch_N%d_d%d%s_rdlat_sweep{0,20,100}\n",
           N, D, causal ? "_causal" : "");
    printf("Test cases run   : 3\n");
    printf("Mismatches       : %d exact%s\n", total_exact_mismatches,
           invariants_ok ? "" : " (performance invariant failure also present)");
    printf("Result           : %s\n", ok ? "PASS" : "FAIL");
    printf("\nRESULT: %s\n", ok ? "PASS" : "FAIL");
    return ok ? 0 : 1;
}
