szuwei-yeh/flashattn-accelerator/sim/verilator/tb_axi_slave.cpp

// ============================================================
//  tb_axi_slave.cpp — Unit test for axi4_stream_slave
//
//  Tests:
//    Test 1: Verify byte routing for first row (head_sel, waddr, wdata)
//    Test 2: Verify mat_sel transitions Q → K → V → load_done
// ============================================================

#include "Vaxi4_stream_slave.h"
#include "verilated.h"
#include <cstdio>
#include <cstdlib>
#include <cstdint>
#include <vector>

static Vaxi4_stream_slave* dut;
static uint64_t sim_time = 0;

static void tick() {
    dut->clk = 0; dut->eval();
    dut->clk = 1; dut->eval();
    sim_time++;
}

static void reset() {
    dut->rst_n   = 0;
    dut->s_tvalid = 0;
    dut->s_tdata  = 0;
    dut->s_tlast  = 0;
    tick(); tick();
    dut->rst_n = 1;
    tick();
}

// Capture one write event
struct WriteEv {
    uint8_t  data;
    uint16_t waddr;
    uint8_t  head;
    uint8_t  mat;   // 0=Q, 1=K, 2=V
};

static std::vector<WriteEv> captured;

// Drive one byte and capture the write event (if we==1).
// Properly handles AXI backpressure: waits for s_tready before capturing.
// This correctly handles the S_IDLE→S_RECV_Q transition on the first byte.
static void drive_byte(uint8_t data, bool last) {
    dut->s_tdata  = data;
    dut->s_tvalid = 1;
    dut->s_tlast  = last ? 1 : 0;

    // Wait for tready (AXI: transfer only when both tvalid and tready are high)
    dut->eval();
    int wait_cnt = 0;
    while (!dut->s_tready) {
        dut->clk = 0; dut->eval();
        dut->clk = 1; dut->eval();
        sim_time++;
        dut->eval();
        if (++wait_cnt > 10000) { printf("drive_byte: tready TIMEOUT\n"); exit(1); }
    }

    // tready is high — capture the write event
    if (dut->we) {
        captured.push_back({
            data,
            (uint16_t)dut->waddr,
            (uint8_t)dut->head_sel,
            (uint8_t)dut->mat_sel
        });
    }

    // Complete the transfer with one clock edge
    dut->clk = 0; dut->eval();
    dut->clk = 1; dut->eval();
    dut->s_tvalid = 0;
    sim_time++;
}

// Send N bytes of a complete matrix (tlast on last byte)
static void send_matrix(int total_bytes, uint8_t fill) {
    for (int i = 0; i < total_bytes; i++) {
        drive_byte(fill, i == total_bytes - 1);
    }
}

int main() {
    dut = new Vaxi4_stream_slave;

    // Default parameters: HEAD_DIM=64, NUM_HEADS=4, PER_HEAD_DIM=16, SEQ_LEN=64
    // Total bytes per matrix = 64 * 64 = 4096

    bool all_pass = true;

    // ----------------------------------------------------------------
    // Test 1: First row routing (64 bytes = one full row)
    //   bytes 0-15  → head=0, mat=Q, waddr=0..15
    //   bytes 16-31 → head=1, mat=Q, waddr=0..15
    //   bytes 32-47 → head=2, mat=Q, waddr=0..15
    //   bytes 48-63 → head=3, mat=Q, waddr=0..15
    // ----------------------------------------------------------------
    printf("[Test 1] First row byte routing (64 bytes)...\n");
    reset();
    captured.clear();

    for (int col = 0; col < 64; col++) {
        drive_byte((uint8_t)col, false);
    }

    bool t1_pass = true;
    if ((int)captured.size() < 64) {
        printf("  ERROR: only %d captured events (expected 64)\n", (int)captured.size());
        t1_pass = false;
    } else {
        // Check bytes 0-15: head=0, mat=0, waddr=0..15, data=col
        for (int col = 0; col < 64; col++) {
            int exp_head  = col / 16;
            int exp_waddr = col % 16;           // per-head column
            // waddr = {row[7:0]=0, phd_col[3:0]}
            int exp_waddr_full = (0 << 4) | exp_waddr;  // row=0

            auto& ev = captured[col];
            if (ev.head != exp_head || ev.mat != 0 ||
                ev.waddr != exp_waddr_full || ev.data != (uint8_t)col) {
                printf("  FAIL byte %d: got head=%d mat=%d waddr=%d data=%d"
                       " (exp head=%d mat=0 waddr=%d data=%d)\n",
                       col, ev.head, ev.mat, ev.waddr, ev.data,
                       exp_head, exp_waddr_full, col);
                t1_pass = false;
            }
        }
    }
    printf("  Test 1: %s\n", t1_pass ? "PASS" : "FAIL");
    if (!t1_pass) all_pass = false;

    // ----------------------------------------------------------------
    // Test 2: mat_sel transitions Q → K → V → load_done
    // Send full Q matrix, first K byte, full K, full V; check transitions.
    // ----------------------------------------------------------------
    printf("[Test 2] mat_sel transitions and load_done...\n");
    reset();
    captured.clear();

    const int N = 64, HD = 64;
    const int total = N * HD;  // 4096

    // Send Q (4096 bytes, tlast on last byte)
    send_matrix(total, 0xAA);
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
