szuwei-yeh/flashattn-accelerator/(commit log)

2026-06-24 fix: treat P operand as unsigned in PV phase
    - array_controller a_unsigned input forces unsigned [0,255] interpretation
    of P operands during the PV matmul phase (softmax probs are non-negative)
    - propagate a_unsigned through systolic_array/pe MAC sign handling
    - wire signal through flash_attn_core / flash_attn_top
    - regenerate all golden expected vectors (generate_hw_expected.py) to match
    [array_controller.sv, dequantizer.sv, exp_lut.sv, flash_attn_core.sv, flash_attn_top.sv, flash_attn_top_axi.sv, online_softmax.sv]
2026-07-06 Add DMA-backed banked scratchpad memory hierarchy
2026-07-06 Add d64 banked DMA targets
2026-07-06 Add AXI write-back DMA path
2026-07-08 Add d=64 flat byte-DMA baseline and 1.30x speedup data point
    Add dma_top_N64_d64 target (byte-DMA + flat core at HEAD_DIM=64) so the
    banked path has a d=64 baseline to compare against, matching the existing
    d=16 comparison. Runs bit-exact at 60421 cycles vs the banked 46412,
    giving a 1.30x speedup (vs 1.26x at d=16). Wired into regression and clean;
    README results table updated with both head dims.
2026-07-08 Tighten local file ignores
    Tidy the repo root: the six gitignored working notes (INTERVIEW_QA,
    PROGRESS, progress2.0, synthesisprogress, WRITEBACK_DMA_PLAN, and the
    memory-hierarchy notes) now live in notes/ instead of cluttering the root.
    Root keeps only the public README.md. .gitignore ignores notes/ explicitly
    and README's link to the synthesis notes is repointed to notes/.
2026-09-02 Fuse output updates and organize synthesis flow
    Fuse rescale and PV accumulation in the banked-prefetch path while preserving the original 32-bit truncation semantics. Replace duplicated DC scripts with tagged, server-driven synthesis runs and macro-aware filelists.
    [flash_attn_core_banked_prefetch.sv, output_buffer.sv, tile_controller_banked_prefetch.sv]
2026-09-25 Fix SRAM/DMA contracts and rebaseline N64 synthesis evidence
    [dma_engine_vec.sv, dma_vec_bench_top.sv, flash_attn_core.sv, flash_attn_core_banked.sv, flash_attn_core_banked_prefetch.sv, flash_attn_top.sv, flash_attn_top_dma_banked.sv]
2026-09-25 Harden regression reporting and expand causal/reset coverage
    [tb_dma_banked_prefetch.cpp, tb_dma_banked_prefetch_contract.cpp, tb_dma_banked_prefetch_harness.sv, test_regression_reporting.py]
2026-10-01 Fix test failure propagation and enforce validated SRAM geometry
    [flash_attn_core_banked_prefetch.sv, flash_attn_top_dma_banked_prefetch.sv, run_vcs_test.py, tb_array_controller.cpp, test_vcs_runner.py]
2026-10-01 Harden fixture parsing and independently verify attention numerics
    [tb_core_banked_prefetch.cpp, tb_dma_banked_prefetch.cpp, tb_dma_banked_prefetch_contract.cpp, tb_fixture_checks.h, test_attention_numerics.py, test_tb_oracles.py]
2026-10-01 Reject DMA and matrix address ranges that wrap
2026-10-01 docs: organize current evidence and navigation
2026-10-03 docs: refresh portfolio overview with architecture and measured cycle figures
    [cycle-milestones.csv]
2026-10-04 feat: add shared dequantizers and reproducible numerical analysis
    Consolidates the October 3 changes in:
    56058f179dfe258e138430ad8812316f1d998431
    d5f9123fbbf73154073b28d683ea4bb88b9e3571
    Exact snapshot tree: 48bc3a68bf2061f4127e9fc3fe63aed126659d64
    Original endpoint: d5f9123fbbf73154073b28d683ea4bb88b9e3571
    [accuracy.csv]
2026-10-04 test: verify shared dequantizers with a pinned CI toolchain
    7a50b78d7df94959fc7d51bd6307a268e86d6f90
    Exact snapshot tree: c3ca2c41bc1ba11a5ee1322ef8b0f5ad66d6d34a
    Original endpoint: 7a50b78d7df94959fc7d51bd6307a268e86d6f90
    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
    [cycles.csv]
2026-10-04 docs: publish matched PPA results and the verification portfolio
    Publish matched 256/32/16-lane PPA, provenance and mapped checks. Organize
    the README around current architecture, measured tradeoffs and reproduction.
    Summarize historical optimizations with their own baselines and conditions,
    and label the configurable score lanes and batch handling in the diagram.
    Record equivalent source snapshots after the October 3 consolidation;
    original manifests, report identities and source hashes remain unchanged.
    The measured implementation snapshot is dd6896461fe19c974b7df1bd366a03a2a0d0a11a.
    The final polish is documentation and figure generation only.
2026-10-04 Add main-path four-state coverage and activity power flows
    [coverage.csv]
2026-10-04 Publish matched workload energy estimates and clock-scope audit
    [activity_annotation.csv, power.csv]
2026-10-04 test: verify reset recovery across attention pipeline stages
    [coverage.csv, reset_recoveries.csv]
